Yuqlid/nmkgmmd_v10_brd/nmkgmmd_v10_brd.xlsx

Reference | Value | Footprint | Datasheet
SW2 | SW_DPDT_x2 | Buttons_Switches_SMD:SW_SPDT_PCM12 | https://www.digikey.jp/product-detail/ja/c-k/PCM12SMTR/401-2016-1-ND/1640125
U1 | STM32F303CCTx | Housings_QFP:LQFP-48_7x7mm_Pitch0.5mm | サンプル
SW1 | SKRPACE010 | SMD_Packages:ALPS_SKRPAxE010 | http://akizukidenshi.com/catalog/g/gP-06185/
R2 | 1k | Resistors_SMD:R_0603 | 手持ち
R1 | 1k | Resistors_SMD:R_0603 | 手持ち
Q3 | PSMN1R0-40YLD | SMD_Packages:LFPAK56_SO8_SOT1023 | http://akizukidenshi.com/catalog/g/gI-09031/
Q2 | PSMN1R0-40YLD | SMD_Packages:LFPAK56_SO8_SOT1023
Q9 | PSMN1R0-40YLD | SMD_Packages:LFPAK56_SO8_SOT1023
Q8 | PSMN1R0-40YLD | SMD_Packages:LFPAK56_SO8_SOT1023
Q7 | PSMN1R0-40YLD | SMD_Packages:LFPAK56_SO8_SOT1023
Q6 | PSMN1R0-40YLD | SMD_Packages:LFPAK56_SO8_SOT1023
Q4 | PSMN1R0-40YLD | SMD_Packages:LFPAK56_SO8_SOT1023
Q5 | PSMN1R0-40YLD | SMD_Packages:LFPAK56_SO8_SOT1023
Q11 | PSMN1R0-40YLD | SMD_Packages:LFPAK56_SO8_SOT1023
Q10 | PSMN1R0-40YLD | SMD_Packages:LFPAK56_SO8_SOT1023
Q17 | PSMN1R0-40YLD | SMD_Packages:LFPAK56_SO8_SOT1023
Q16 | PSMN1R0-40YLD | SMD_Packages:LFPAK56_SO8_SOT1023
Q15 | PSMN1R0-40YLD | SMD_Packages:LFPAK56_SO8_SOT1023
Q14 | PSMN1R0-40YLD | SMD_Packages:LFPAK56_SO8_SOT1023
Q12 | PSMN1R0-40YLD | SMD_Packages:LFPAK56_SO8_SOT1023
Q13 | PSMN1R0-40YLD | SMD_Packages:LFPAK56_SO8_SOT1023
U3 | MCP16301 | TO_SOT_Packages_SMD:SOT-23-6 | サンプル
U2 | MCP16301 | TO_SOT_Packages_SMD:SOT-23-6 | サンプル
D5 | LED | LEDs:LED_0603 | 秋月電子で適当に買ってくる
D4 | LED | LEDs:LED_0603
D3 | LED | LEDs:LED_0603
D2 | LED | LEDs:LED_0603
D1 | LED | LEDs:LED_0603
L2 | L | Inductors_NEOSID:Neosid_Inductor_SM0603CG | http://akizukidenshi.com/catalog/g/gP-10766/
L1 | L | Inductors_NEOSID:Neosid_Inductor_SM0603CG
D7 | D_Schottky | Diodes_SMD:D_SOD-123 | http://akizukidenshi.com/catalog/g/gI-02073/
D6 | D_Schottky | Diodes_SMD:D_SOD-123
D9 | D | Diodes_SMD:D_SOD-323_HandSoldering | https://www.digikey.jp/product-detail/ja/smc-diode-solutions/1N4148WSTR/1655-1359-1-ND/6022804
D8 | D | Diodes_SMD:D_SOD-323_HandSoldering
D11 | D | Diodes_SMD:D_SOD-123 | http://akizukidenshi.com/catalog/g/gI-02073/
D10 | D | Diodes_SMD:D_SOD-123
Y1 | Crystal | Crystals:NDK_Crystal_SMD_3225_2Pads | https://www.digikey.jp/product-detail/ja/ndk-america-inc/NX3225GD-8MHZ-STD-CRA-3/644-1178-1-ND/3125567
J9 | CONN_01X10 | Pin_Headers:Pin_Header_Straight_1x10_Pitch2.00mm_SMD_Pin1Right
J20 | CONN_01X10 | Pin_Headers:Pin_Header_Straight_1x10_Pitch2.00mm_SMD_Pin1Left
J14 | CONN_01X10 | Pin_Headers:Pin_Header_Straight_1x10_Pitch2.00mm_SMD_Pin1Left
J10 | CONN_01X10 | Pin_Headers:Pin_Header_Straight_1x10_Pitch2.00mm_SMD_Pin1Right
J1 | CONN_01X05 | Connectors_JST:JST_SH_BM05B-SRSS-TB_05x1.00mm_Straight
J6 | CONN_01X04 | Connectors_JST:JST_ZH_B04B-ZR_04x1.50mm_Straight | https://www.digikey.jp/product-detail/ja/jst-sales-america-inc/B4B-ZR(LF)(SN)/455-1659-ND/926566 |  | 千石で買える
J5 | CONN_01X04 | Connectors_JST:JST_ZH_S04B-ZR_04x1.50mm_Angled | https://www.digikey.jp/product-detail/ja/jst-sales-america-inc/S4B-ZR(LF)(SN)/455-1671-ND/926578
J4 | CONN_01X04 | Connectors_JST:JST_ZH_S04B-ZR_04x1.50mm_Angled | https://www.digikey.jp/product-detail/ja/jst-sales-america-inc/S4B-ZR(LF)(SN)/455-1671-ND/926578
J8 | CONN_01X03 | Connectors_JST:JST_ZH_S03B-ZR_03x1.50mm_Angled | https://www.digikey.jp/product-detail/ja/jst-sales-america-inc/S3B-ZR(LF)(SN)/455-1670-ND/926577
J7 | CONN_01X03 | Connectors_JST:JST_ZH_S03B-ZR_03x1.50mm_Angled | https://www.digikey.jp/product-detail/ja/jst-sales-america-inc/S3B-ZR(LF)(SN)/455-1670-ND/926577
J3 | CONN_01X03 | Connectors_JST:JST_ZH_S03B-ZR_03x1.50mm_Angled | https://www.digikey.jp/product-detail/ja/jst-sales-america-inc/S3B-ZR(LF)(SN)/455-1670-ND/926577
J2 | CONN_01X03 | Connectors_JST:JST_ZH_S03B-ZR_03x1.50mm_Angled | https://www.digikey.jp/product-detail/ja/jst-sales-america-inc/S3B-ZR(LF)(SN)/455-1670-ND/926577
J24 | CONN_01X01 | Mounting_Holes:MountingHole_2.7mm_Pad_Via
J23 | CONN_01X01 | Mounting_Holes:MountingHole_2.7mm_Pad_Via
J22 | CONN_01X01 | Mounting_Holes:MountingHole_2.7mm_Pad_Via
J21 | CONN_01X01 | Mounting_Holes:MountingHole_2.7mm_Pad_Via
J18 | CONN_01X01 | Mounting_Holes:MountingHole_2.7mm_Pad_Via
J17 | CONN_01X01 | Mounting_Holes:MountingHole_2.7mm_Pad_Via
J16 | CONN_01X01 | Mounting_Holes:MountingHole_2.7mm_Pad_Via
J15 | CONN_01X01 | Mounting_Holes:MountingHole_2.7mm_Pad_Via
C38 | C | Capacitors_SMD:C_0603 |  | https://www.digikey.jp/product-detail/ja/kemet/C0603C104K5RACTU/399-5089-1-ND/1465623 | 0.1uでよくね
C37 | C | Capacitors_SMD:C_0603
C36 | C | Capacitors_SMD:C_0603
C35 | C | Capacitors_SMD:C_0603
C34 | C | Capacitors_SMD:C_0603
C33 | C | Capacitors_SMD:C_0603
C32 | C | Capacitors_SMD:C_0603
C31 | C | Capacitors_SMD:C_0603
Q18 | BSS138 | TO_SOT_Packages_SMD:SOT-23 | http://akizukidenshi.com/catalog/g/gI-11627/
Q1 | BSS138 | TO_SOT_Packages_SMD:SOT-23 | http://akizukidenshi.com/catalog/g/gI-11627/
U7 | ACS711 | Housings_DFN_QFN:QFN-12_3x3mm_Pitch0.5mm_With_Fused_Sensed_Current_Loop | https://www.digikey.jp/product-detail/ja/allegro-microsystems-llc/ACS711KEXLT-31AB-T/620-1482-1-ND/3868202
U5 | ACS711 | Housings_DFN_QFN:QFN-12_3x3mm_Pitch0.5mm_With_Fused_Sensed_Current_Loop | https://www.digikey.jp/product-detail/ja/allegro-microsystems-llc/ACS711KEXLT-31AB-T/620-1482-1-ND/3868202
U6 | A4957 | SMD_Packages:Allegro_A4957_QFN-24-1EP_4x4mm_Pitch0.5mm | https://www.digikey.jp/product-detail/ja/allegro-microsystems-llc/A4957SESTR-T/620-1491-1-ND/3906431
U4 | A4957 | SMD_Packages:Allegro_A4957_QFN-24-1EP_4x4mm_Pitch0.5mm | https://www.digikey.jp/product-detail/ja/allegro-microsystems-llc/A4957SESTR-T/620-1491-1-ND/3906431
R15 | 52.3k | Resistors_SMD:R_0603 | https://www.digikey.jp/product-detail/ja/yageo/RC0603FR-0752K3L/311-52.3KHRCT-ND/730237
C27 | 4.4u | Capacitors_SMD:C_0805 | https://www.digikey.jp/product-detail/ja/samsung-electro-mechanics-america-inc/CL21A475KOFNNNG/1276-6463-1-ND/5958091 |  | 0.22u×20=4.4u<4.7u で
C20 | 4.4u | Capacitors_SMD:C_0805
C26 | 470n | Capacitors_SMD:C_0603 | https://www.digikey.jp/product-detail/ja/taiyo-yuden/UMK107B7474KA-TR/587-3170-1-ND/3194939
C19 | 470n | Capacitors_SMD:C_0603
R10 | 40k | Resistors_SMD:R_0603 | https://www.digikey.jp/product-detail/ja/yageo/RC0603FR-0739K2L/311-39.2KHRCT-ND/730144 |  | 39.2k
R17 | 31.6k | Resistors_SMD:R_0603 | https://www.digikey.jp/product-detail/ja/yageo/RC0603FR-0731K6L/311-31.6KHRCT-ND/730098
L3 | 22u | Choke_SMD:Choke_SMD_BOURNS-SRR4028-xxxY | https://www.digikey.jp/product-detail/ja/bourns-inc/SRN4026-220M/SRN4026-220MCT-ND/4867777
C15 | 20u | Capacitors_SMD:C_0805 | http://akizukidenshi.com/catalog/g/gP-06057/
C9 | 1u | Capacitors_SMD:C_0603 | http://akizukidenshi.com/catalog/g/gP-09633/
C4 | 1u | Capacitors_SMD:C_0603
R9 | 1k | Resistors_SMD:R_0603 | https://www.digikey.jp/product-detail/ja/yageo/RC0603FR-071KL/311-1.00KHRCT-ND/729790
R8 | 1k | Resistors_SMD:R_0603
R7 | 1k | Resistors_SMD:R_0603
L4 | 15u | Choke_SMD:Choke_SMD_BOURNS-SRR4028-xxxY | https://www.digikey.jp/product-detail/ja/bourns-inc/SRN4012TA-150M/SRN4012TA-150MCT-ND/6155227
C3 | 14p | Capacitors_SMD:C_0603 | https://www.digikey.jp/product-detail/ja/samsung-electro-mechanics-america-inc/CL10C140JB8NNNC/1276-2187-1-ND/3890273
C2 | 14p | Capacitors_SMD:C_0603
C16 | 10u | Capacitors_SMD:C_0805 | http://akizukidenshi.com/catalog/g/gP-06057/ |  | 5Vよ同じように22uF付ける
C12 | 10u | Capacitors_SMD:C_0805 | http://akizukidenshi.com/catalog/g/gP-06462/ |  | ミスったのでこっちも3216サイズに変更
C11 | 10u | Capacitors_SMD:C_0805
R6 | 10k | Resistors_SMD:R_0603 | https://www.digikey.jp/product-detail/ja/susumu/RR0816P-103-D/RR08P10.0KDCT-ND/432748 |  | 部室にある
R52 | 10k | Resistors_SMD:R_0603
R51 | 10k | Resistors_SMD:R_0603
R5 | 10k | Resistors_SMD:R_0603
R48 | 10k | Resistors_SMD:R_0603
R47 | 10k | Resistors_SMD:R_0603
R46 | 10k | Resistors_SMD:R_0603
R45 | 10k | Resistors_SMD:R_0603
R42 | 10k | Resistors_SMD:R_0603
R41 | 10k | Resistors_SMD:R_0603
R4 | 10k | Resistors_SMD:R_0603
R37 | 10k | Resistors_SMD:R_0603
R34 | 10k | Resistors_SMD:R_0603
R33 | 10k | Resistors_SMD:R_0603
R30 | 10k | Resistors_SMD:R_0603
R3 | 10k | Resistors_SMD:R_0603
R29 | 10k | Resistors_SMD:R_0603
R28 | 10k | Resistors_SMD:R_0603
R27 | 10k | Resistors_SMD:R_0603
R24 | 10k | Resistors_SMD:R_0603
R23 | 10k | Resistors_SMD:R_0603
R19 | 10k | Resistors_SMD:R_0603
R18 | 10k | Resistors_SMD:R_0603
R16 | 10k | Resistors_SMD:R_0603
R14 | 10k | Resistors_SMD:R_0603
R13 | 10k | Resistors_SMD:R_0603
R12 | 10k | Resistors_SMD:R_0603
R11 | 10k | Resistors_SMD:R_0603
C29 | 0.22u | Capacitors_SMD:C_0603 | https://www.digikey.jp/product-detail/ja/tdk-corporation/C1608X7R1C224K080AC/445-1318-1-ND/567690 |  | 0.22uFあればいいと思う
C28 | 0.22u | Capacitors_SMD:C_0603
C22 | 0.22u | Capacitors_SMD:C_0603
C21 | 0.22u | Capacitors_SMD:C_0603
C8 | 0.1u | Capacitors_SMD:C_0603 | https://www.digikey.jp/product-detail/ja/kemet/C0603C104K5RACTU/399-5089-1-ND/1465623 |  | 部室にある
C7 | 0.1u | Capacitors_SMD:C_0603
C6 | 0.1u | Capacitors_SMD:C_0603
C5 | 0.1u | Capacitors_SMD:C_0603
C30 | 0.1u | Capacitors_SMD:C_0603
C25 | 0.1u | Capacitors_SMD:C_0603
C24 | 0.1u | Capacitors_SMD:C_0603
C23 | 0.1u | Capacitors_SMD:C_0603
C18 | 0.1u | Capacitors_SMD:C_0603
C17 | 0.1u | Capacitors_SMD:C_0603
C14 | 0.1u | Capacitors_SMD:C_0603
C13 | 0.1u | Capacitors_SMD:C_0603
C10 | 0.1u | Capacitors_SMD:C_0603
C1 | 0.1u | Capacitors_SMD:C_0603
R54 | 10 | Resistors_SMD:R_0603 | https://www.sengoku.co.jp/mod/sgk_cart/detail.php?code=7APR-EFEC
R53 | 10 | Resistors_SMD:R_0603
R50 | 10 | Resistors_SMD:R_0603
R49 | 10 | Resistors_SMD:R_0603
R44 | 10 | Resistors_SMD:R_0603
R43 | 10 | Resistors_SMD:R_0603
R40 | 10 | Resistors_SMD:R_0603
R39 | 10 | Resistors_SMD:R_0603
R36 | 10 | Resistors_SMD:R_0603
R35 | 10 | Resistors_SMD:R_0603
R32 | 10 | Resistors_SMD:R_0603
R31 | 10 | Resistors_SMD:R_0603
R26 | 10 | Resistors_SMD:R_0603
R25 | 10 | Resistors_SMD:R_0603
R22 | 10 | Resistors_SMD:R_0603
R21 | 10 | Resistors_SMD:R_0603
R38 | 0 | Resistors_SMD:R_0603 | http://akizukidenshi.com/catalog/g/gR-11619/
R20 | 0 | Resistors_SMD:R_0603
