Yuqlid/nmkgmmd_v10_brd/nmkgmmd_v10_brd.kicad_pcb

## KiCad design nmkgmmd_v10_brd.kicad_pcb (2017-05-09)

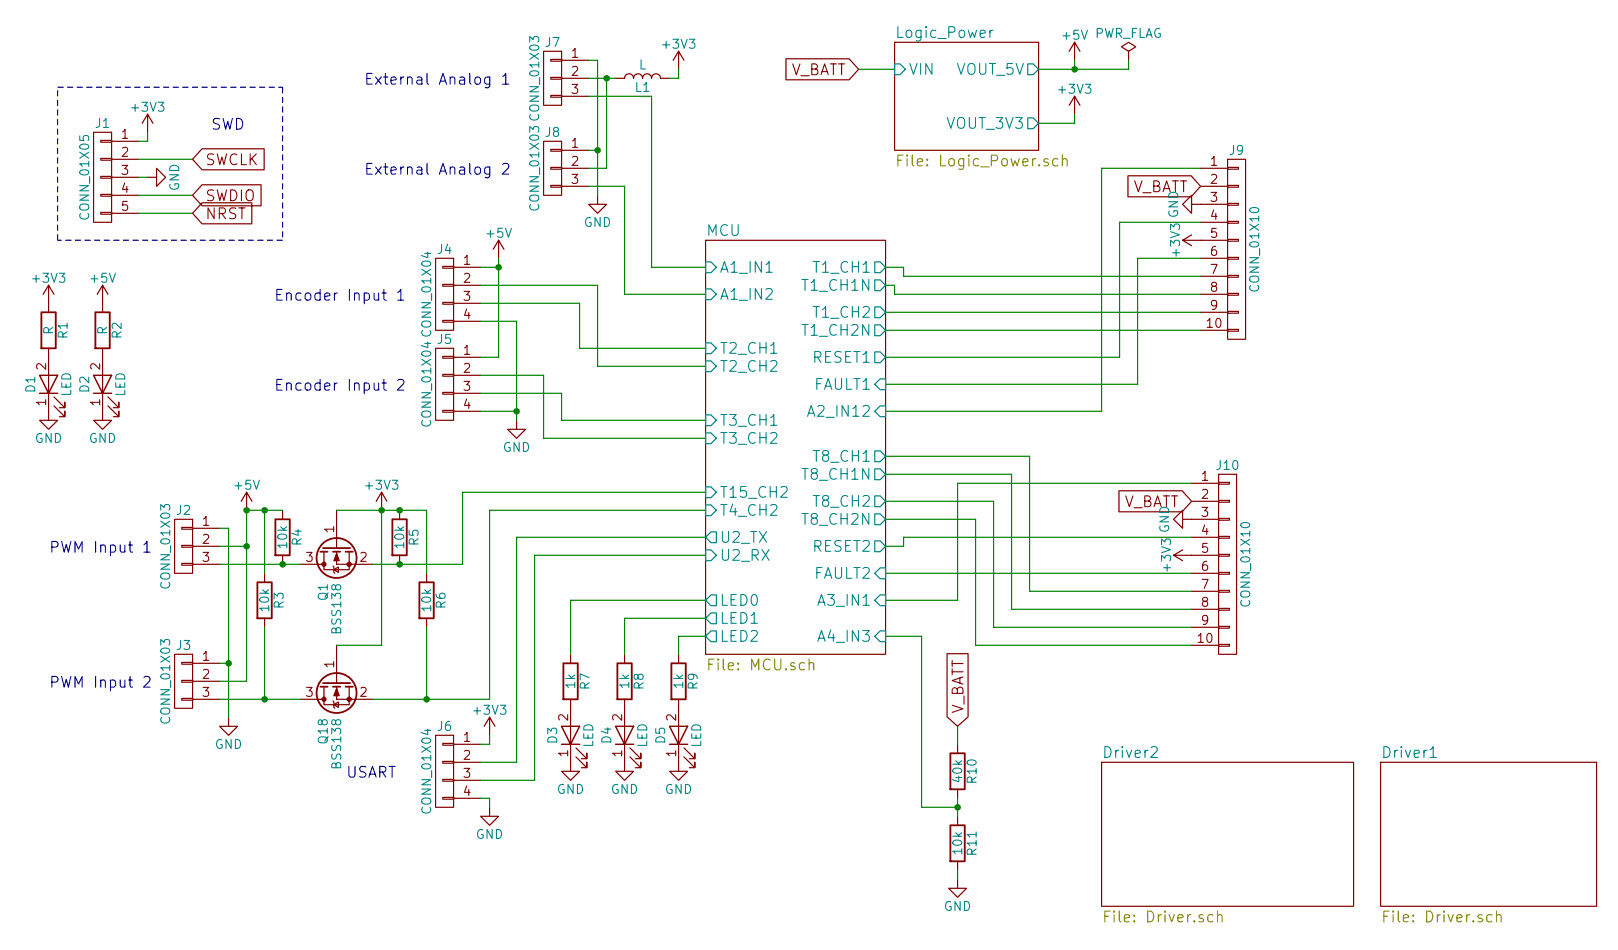
[picture p1: schematic nmkgmmd_v10_brd.sch]

Parts:
D1, D2, D3, D4, D5: LED; LED_0603
J1: CONN_01X05; JST_SH_BM05B-SRSS-TB_05x1.00mm_Straight
J2, J3, J7, J8: CONN_01X03; JST_ZH_S03B-ZR_03x1.50mm_Angled
J4, J5: CONN_01X04; JST_ZH_S04B-ZR_04x1.50mm_Angled
J6: CONN_01X04; JST_ZH_B04B-ZR_04x1.50mm_Straight
J9, J10: CONN_01X10; Pin_Header_Straight_1x10_Pitch2.00mm_SMD_Pin1Right
L1: L; Neosid_Inductor_SM0603CG
Q1, Q18: BSS138; SOT-23
R1, R2: R; R_0603
R3, R4, R5, R6, R11: 10k; R_0603
R7, R8, R9: 1k; R_0603
R10: 40k; R_0603

Connections:
+3V3: J1.1, J6.1, J9.5, J10.5, L1.2, Q1.1 (G), Q18.1 (G), R1.1, R5.1, R6.1; also elsewhere on the board
+5V: J2.2, J3.2, J4.1, J5.1, R2.1, R3.1, R4.1; also elsewhere on the board
/MCU/A1_IN1: J7.3; also elsewhere on the board
/MCU/A1_IN2: J8.3; also elsewhere on the board
/MCU/A2_IN12: J9.1; also elsewhere on the board
/MCU/A3_IN1: J10.1; also elsewhere on the board
/MCU/A4_IN3: R10.2, R11.1; also elsewhere on the board
/MCU/FAULT1: J9.6; also elsewhere on the board
/MCU/FAULT2: J10.6; also elsewhere on the board
/MCU/LED0: R7.1; also elsewhere on the board
/MCU/LED1: R8.1; also elsewhere on the board
/MCU/LED2: R9.1; also elsewhere on the board
/MCU/RESET1: J9.4; also elsewhere on the board
/MCU/RESET2: J10.4; also elsewhere on the board
/MCU/T1_CH1: J9.7; also elsewhere on the board
/MCU/T1_CH1N: J9.8; also elsewhere on the board
/MCU/T1_CH2: J9.9; also elsewhere on the board
/MCU/T1_CH2N: J9.10; also elsewhere on the board
/MCU/T2_CH1: J4.3; also elsewhere on the board
/MCU/T2_CH2: J4.2; also elsewhere on the board
/MCU/T3_CH1: J5.3; also elsewhere on the board
/MCU/T3_CH2: J5.2; also elsewhere on the board
/MCU/T4_CH2: Q18.2 (S), R6.2; also elsewhere on the board
/MCU/T8_CH1: J10.7; also elsewhere on the board
/MCU/T8_CH1N: J10.8; also elsewhere on the board
/MCU/T8_CH2: J10.9; also elsewhere on the board
/MCU/T8_CH2N: J10.10; also elsewhere on the board
/MCU/T15_CH2: Q1.2 (S), R5.2; also elsewhere on the board
/MCU/U2_RX: J6.3; also elsewhere on the board
/MCU/U2_TX: J6.2; also elsewhere on the board
GND: D1.1 (K), D2.1 (K), D3.1 (K), D4.1 (K), D5.1 (K), J1.3, J2.1, J3.1, J4.4, J5.4, J6.4, J7.1, J8.1, J9.3, J10.3, R11.2; also elsewhere on the board
NRST: J1.5; also elsewhere on the board
unnamed: D1.2 (A), R1.2
unnamed: D2.2 (A), R2.2
unnamed: D3.2 (A), R7.2
unnamed: D4.2 (A), R8.2
unnamed: D5.2 (A), R9.2
unnamed: J2.3, Q1.3 (D), R4.2
unnamed: J3.3, Q18.3 (D), R3.2
unnamed: J7.2, J8.2, L1.1
SWCLK: J1.2; also elsewhere on the board
SWDIO: J1.4; also elsewhere on the board
V_BATT: J9.2, J10.2, R10.1; also elsewhere on the board

Notes on the sheet:
SWD
Encoder Input 1
Encoder Input 2
External Analog 1
External Analog 2
PWM Input 1
PWM Input 2
USART

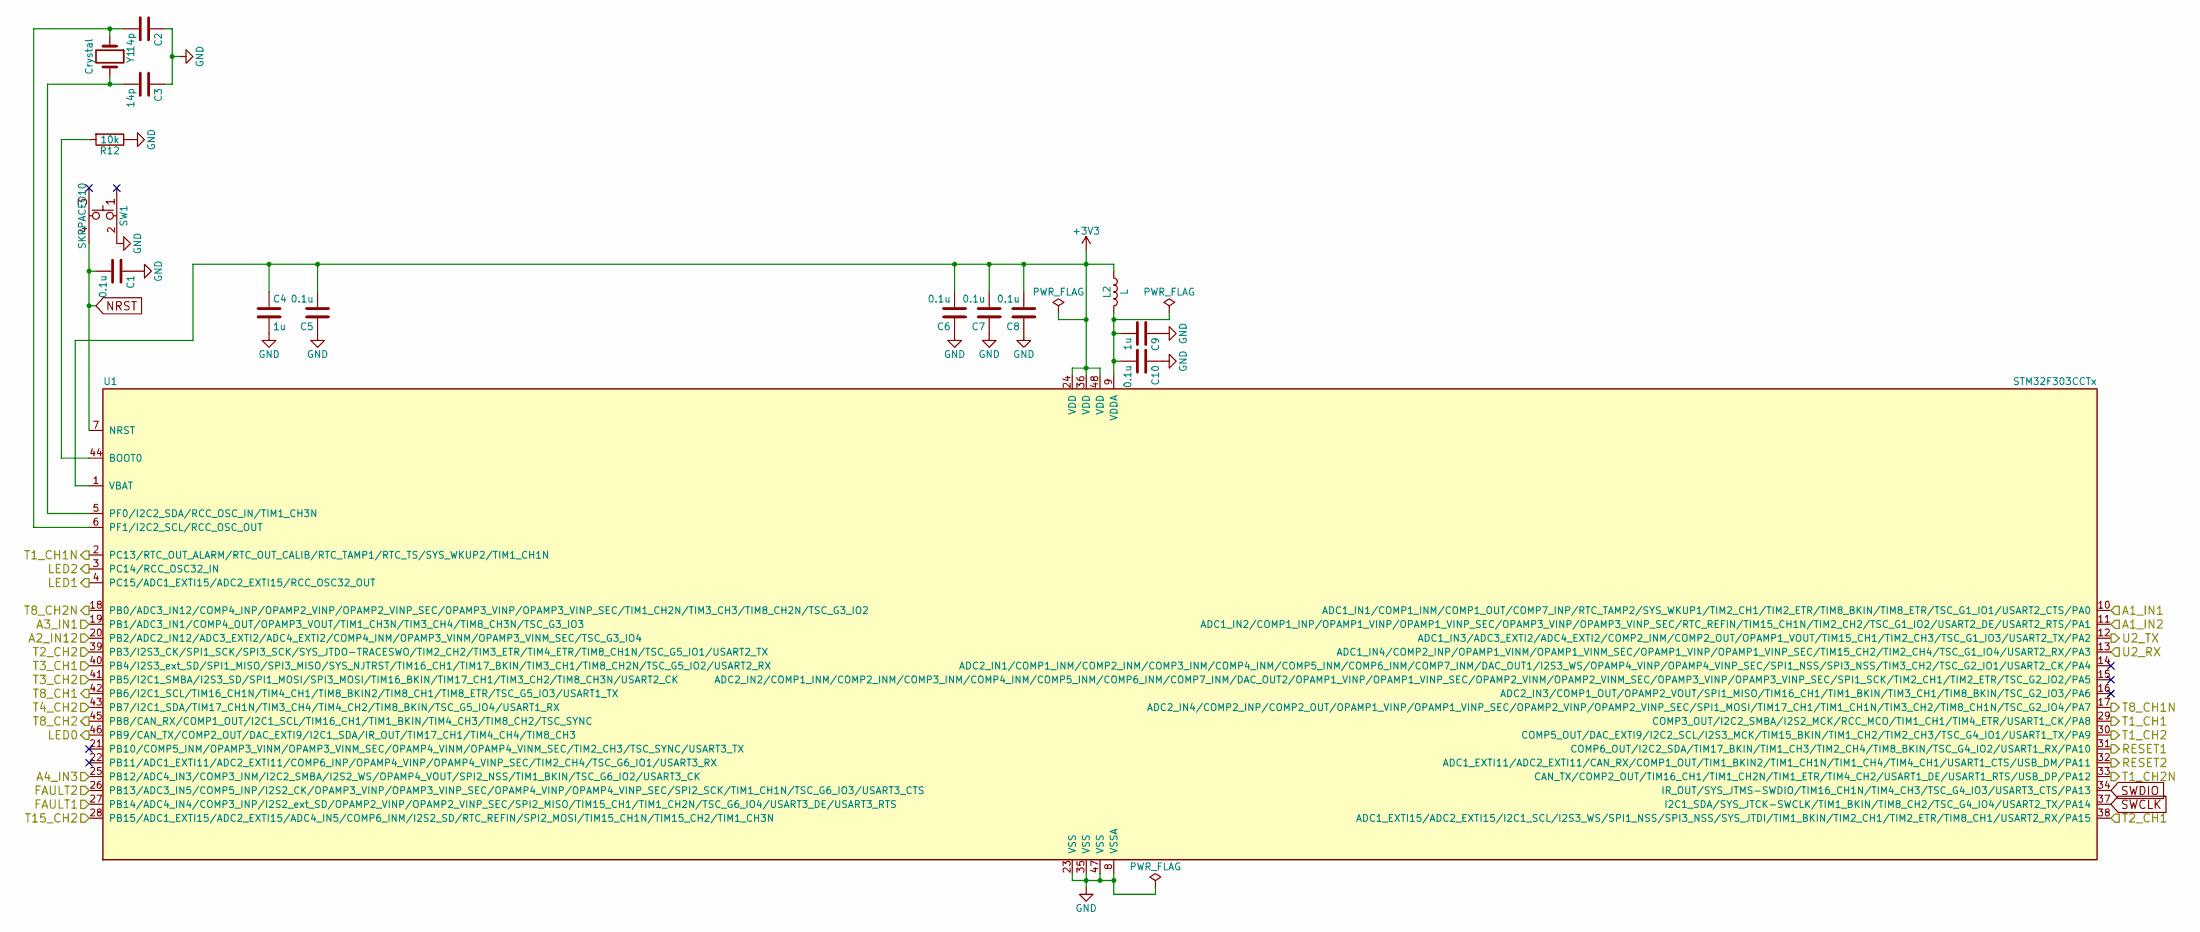
[picture p2: schematic MCU.sch]

Parts:
C1, C5, C6, C7, C8, C10: 0.1u; C_0603
C2, C3: 14p; C_0603
C4, C9: 1u; C_0603
L2: L; Neosid_Inductor_SM0603CG
R12: 10k; R_0603
SW1: SKRPACE010; ALPS_SKRPAxE010
U1: STM32F303CCTx; LQFP-48_7x7mm_Pitch0.5mm
Y1: Crystal; NDK_Crystal_SMD_3225_2Pads

Connections:
+3V3: C4.1, C5.2, C6.2, C7.2, C8.2, L2.1, U1.1 (VBAT), U1.24 (VDD), U1.36 (VDD), U1.48 (VDD); also elsewhere on the board
/MCU/A1_IN1: U1.10 (ADC1_IN1/COMP1_INM/COMP1_OUT/COMP7_INP/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); also elsewhere on the board
/MCU/A1_IN2: U1.11 (ADC1_IN2/COMP1_INP/OPAMP1_VINP/OPAMP1_V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); also elsewhere on the board
/MCU/A2_IN12: U1.20 (PB2/ADC2_IN12/ADC3_EXTI2/ADC4_EXTI2/COM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); also elsewhere on the board
/MCU/A3_IN1: U1.19 (PB1/ADC3_IN1/COMP4_OUT/OPAMP3_VOUT/TIM1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); also elsewhere on the board
/MCU/A4_IN3: U1.25 (PB12/ADC4_IN3/COMP3_INM/I2C2_SMBA/I2S2_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); also elsewhere on the board
/MCU/FAULT1: U1.27 (PB14/ADC4_IN4/COMP3_INP/I2S2_ext_SD/OPA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); also elsewhere on the board
/MCU/FAULT2: U1.26 (PB13/ADC3_IN5/COMP5_INP/I2S2_CK/OPAMP3_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); also elsewhere on the board
/MCU/LED0: U1.46 (PB9/CAN_TX/COMP2_OUT/DAC_EXTI9/I2C1_SDA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); also elsewhere on the board
/MCU/LED1: U1.4 (PC15/ADC1_EXTI15/ADC2_EXTI15/RCC_OSC32_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); also elsewhere on the board
/MCU/LED2: U1.3 (PC14/RCC_OSC32_IN); also elsewhere on the board
/MCU/RESET1: U1.31 (COMP6_OUT/I2C2_SDA/TIM17_BKIN/TIM1_CH3/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); also elsewhere on the board
/MCU/RESET2: U1.32 (ADC1_EXTI11/ADC2_EXTI11/CAN_RX/COMP1_OU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); also elsewhere on the board
/MCU/T1_CH1: U1.29 (COMP3_OUT/I2C2_SMBA/I2S2_MCK/RCC_MCO/TI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); also elsewhere on the board
/MCU/T1_CH1N: U1.2 (PC13/RTC_OUT_ALARM/RTC_OUT_CALIB/RTC_TA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); also elsewhere on the board
/MCU/T1_CH2: U1.30 (COMP5_OUT/DAC_EXTI9/I2C2_SCL/I2S3_MCK/T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); also elsewhere on the board
/MCU/T1_CH2N: U1.33 (CAN_TX/COMP2_OUT/TIM16_CH1/TIM1_CH2N/TI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); also elsewhere on the board
/MCU/T2_CH1: U1.38 (ADC1_EXTI15/ADC2_EXTI15/I2C1_SCL/I2S3_W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); also elsewhere on the board
/MCU/T2_CH2: U1.39 (PB3/I2S3_CK/SPI1_SCK/SPI3_SCK/SYS_JTDO-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); also elsewhere on the board
/MCU/T3_CH1: U1.40 (PB4/I2S3_ext_SD/SPI1_MISO/SPI3_MISO/SYS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); also elsewhere on the board
/MCU/T3_CH2: U1.41 (PB5/I2C1_SMBA/I2S3_SD/SPI1_MOSI/SPI3_MO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); also elsewhere on the board
/MCU/T4_CH2: U1.43 (PB7/I2C1_SDA/TIM17_CH1N/TIM3_CH4/TIM4_C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); also elsewhere on the board
/MCU/T8_CH1: U1.42 (PB6/I2C1_SCL/TIM16_CH1N/TIM4_CH1/TIM8_B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); also elsewhere on the board
/MCU/T8_CH1N: U1.17 (ADC2_IN4/COMP2_INP/COMP2_OUT/OPAMP1_VIN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); also elsewhere on the board
/MCU/T8_CH2: U1.45 (PB8/CAN_RX/COMP1_OUT/I2C1_SCL/TIM16_CH1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); also elsewhere on the board
/MCU/T8_CH2N: U1.18 (PB0/ADC3_IN12/COMP4_INP/OPAMP2_VINP/OPA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); also elsewhere on the board
/MCU/T15_CH2: U1.28 (PB15/ADC1_EXTI15/ADC2_EXTI15/ADC4_IN5/C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); also elsewhere on the board
/MCU/U2_RX: U1.13 (ADC1_IN4/COMP2_INP/OPAMP1_VINM/OPAMP1_V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); also elsewhere on the board
/MCU/U2_TX: U1.12 (ADC1_IN3/ADC3_EXTI2/ADC4_EXTI2/COMP2_IN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); also elsewhere on the board
GND: C1.1, C2.1, C3.1, C4.2, C5.1, C6.1, C7.1, C8.1, C9.1, C10.1, R12.1, SW1.2, U1.8 (VSSA), U1.23 (VSS), U1.35 (VSS), U1.47 (VSS); also elsewhere on the board
NRST: C1.2, SW1.4, U1.7 (NRST); also elsewhere on the board
unnamed: C2.2, U1.6 (PF1/I2C2_SCL/RCC_OSC_OUT), Y1.1
unnamed: C3.2, U1.5 (PF0/I2C2_SDA/RCC_OSC_IN/TIM1_CH3N), Y1.2
unnamed: C9.2, C10.2, L2.2, U1.9 (VDDA)
unnamed: R12.2, U1.44 (BOOT0)
SWCLK: U1.37 (I2C1_SDA/SYS_JTCK-SWCLK/TIM1_BKIN/TIM8_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); also elsewhere on the board
SWDIO: U1.34 (IR_OUT/SYS_JTMS-SWDIO/TIM16_CH1N/TIM4_C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); also elsewhere on the board

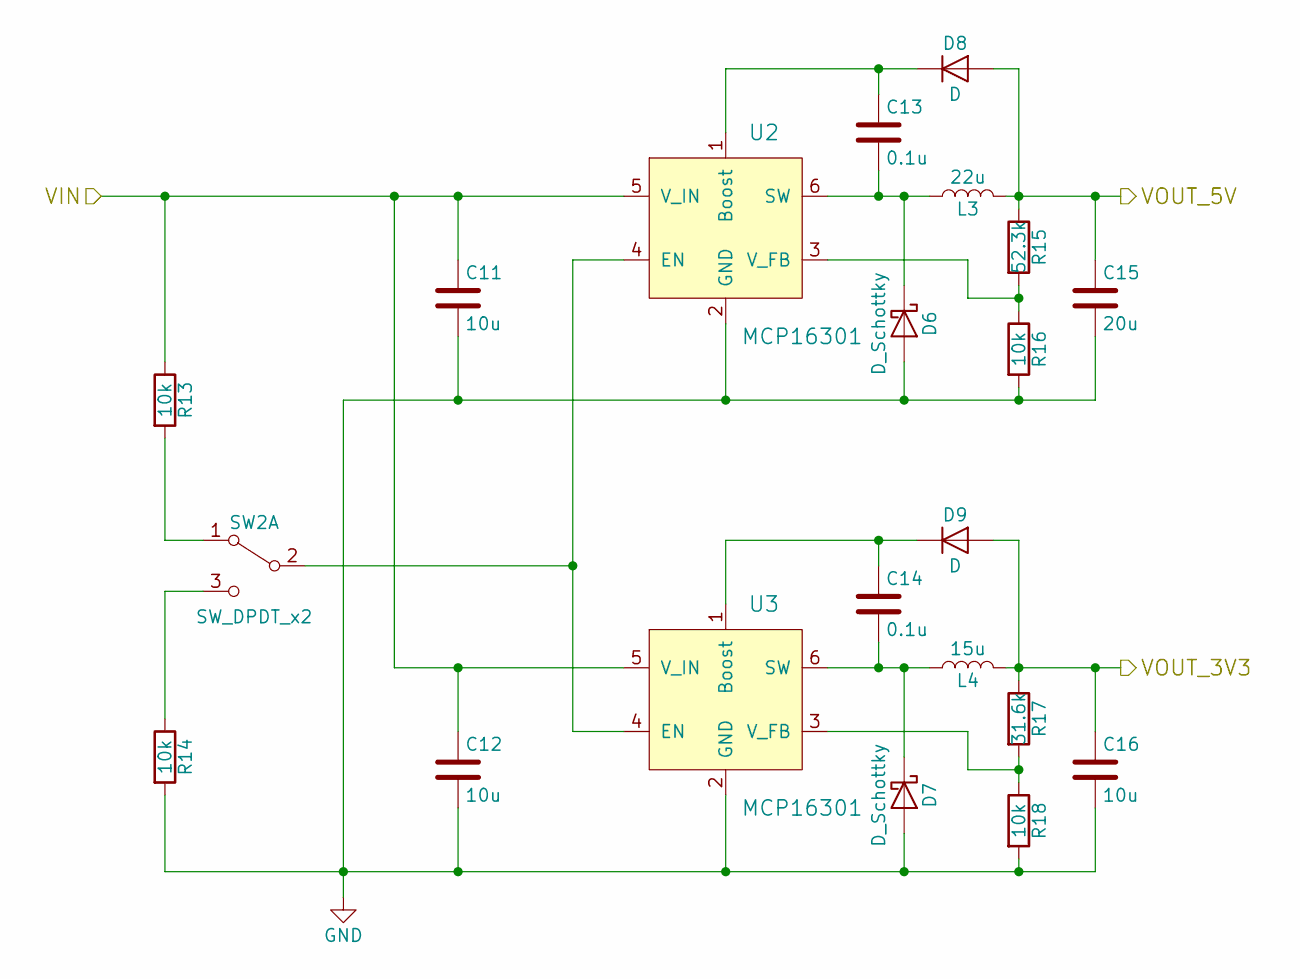
[picture p3: schematic Logic_Power.sch]

Parts:
C11, C12, C16: 10u; C_0805
C13, C14: 0.1u; C_0603
C15: 20u; C_0805
D6, D7: D_Schottky; D_SOD-123
D8, D9: D; D_SOD-323_HandSoldering
L3: 22u; Choke_SMD_BOURNS-SRR4028-xxxY
L4: 15u; Choke_SMD_BOURNS-SRR4028-xxxY
R13, R14, R16, R18: 10k; R_0603
R15: 52.3k; R_0603
R17: 31.6k; R_0603
SW2: SW_DPDT_x2; SW_SPDT_PCM12
U2, U3: MCP16301; SOT-23-6

Connections:
+3V3: C16.1, D9.2 (A), L4.2, R17.1; also elsewhere on the board
+5V: C15.1, D8.2 (A), L3.2, R15.1; also elsewhere on the board
GND: C11.2, C12.2, C15.2, C16.2, D6.2 (A), D7.2 (A), R14.2, R16.2, R18.2, U2.2 (GND), U3.2 (GND); also elsewhere on the board
unnamed: C13.1, D8.1 (K), U2.1 (Boost)
unnamed: C13.2, D6.1 (K), L3.1, U2.6 (SW)
unnamed: C14.1, D9.1 (K), U3.1 (Boost)
unnamed: C14.2, D7.1 (K), L4.1, U3.6 (SW)
unnamed: R13.2, SW2.1 (A)
unnamed: R14.1, SW2.3 (C)
unnamed: R15.2, R16.1, U2.3 (V_FB)
unnamed: R17.2, R18.1, U3.3 (V_FB)
unnamed: SW2.2 (B), U2.4 (EN), U3.4 (EN)
V_BATT: C11.1, C12.1, R13.1, U2.5 (V_IN), U3.5 (V_IN); also elsewhere on the board

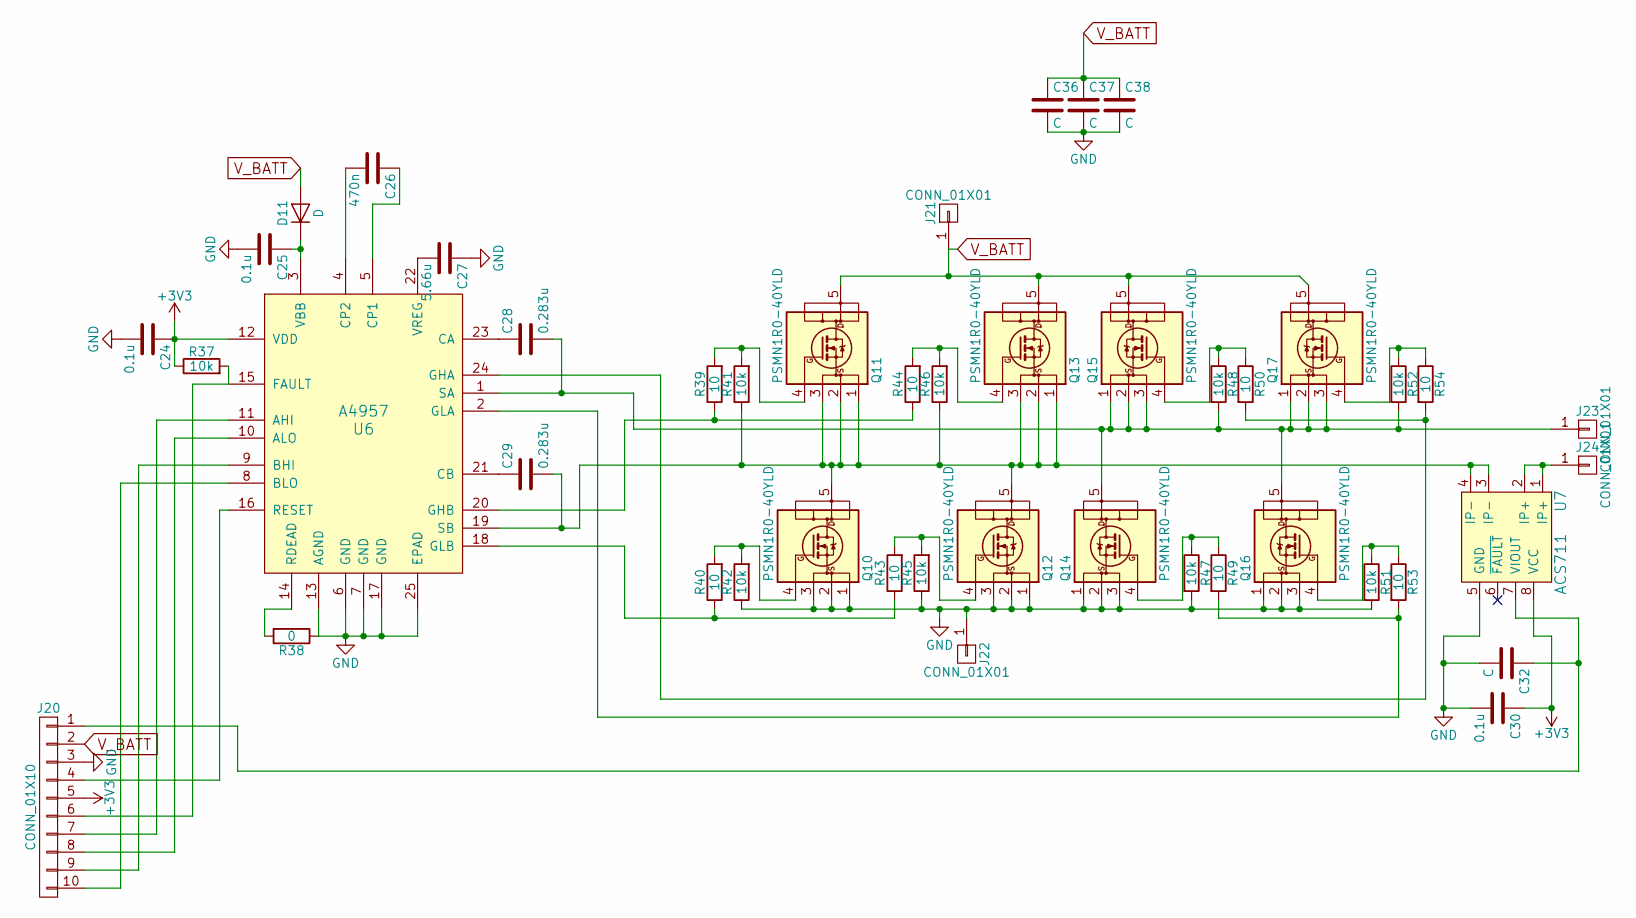
[picture p4: schematic Driver.sch]

Parts:
C17, C18, C23: 0.1u; C_0603
C19: 470n; C_0603
C20: 5.66u; C_0805
C21, C22: 0.283u; C_0603
C32, C33, C34, C35: C; C_0603
D10: D; D_SOD-123
J14: CONN_01X10; Pin_Header_Straight_1x10_Pitch2.00mm_SMD_Pin1Left
J15, J16, J17, J18: CONN_01X01; MountingHole_2.7mm_Pad_Via
Q2, Q3, Q4, Q5, Q6, Q7, Q8, Q9: PSMN1R0-40YLD; LFPAK56_SO8_SOT1023
R19, R23, R24, R27, R28, R29, R30, R33, R34: 10k; R_0603
R20: 0; R_0603
R21, R22, R25, R26, R31, R32, R35, R36: 10; R_0603
U4: A4957; Allegro_A4957_QFN-24-1EP_4x4mm_Pitch0.5mm
U7: ACS711; QFN-12_3x3mm_Pitch0.5mm_With_Fused_Sensed_Current_Loop

Connections:
+3V3: C17.1, C23.1, J14.5, R19.1, U4.12 (VDD), U7.8 (VCC); also elsewhere on the board
GND: C17.2, C18.2, C20.1, C23.2, C32.2, C33.2, C34.2, C35.2, J14.3, J16.1, Q2.1 (S), Q2.2 (S), Q2.3 (S), Q4.1 (S), Q4.2 (S), Q4.3 (S), Q6.1 (S), Q6.2 (S), Q6.3 (S), Q8.1 (S), Q8.2 (S), Q8.3 (S), R20.1, R24.1, R27.1, R29.2, R33.2, U4.6 (GND), U4.7 (GND), U4.13 (AGND), U4.17 (GND), U4.25 (EPAD), U7.5 (GND); also elsewhere on the board
unnamed: C18.1, D10.1 (K), U4.3 (VBB)
unnamed: C19.1, U4.5 (CP1)
unnamed: C19.2, U4.4 (CP2)
unnamed: C20.2, U4.22 (VREG)
unnamed: C21.1, U4.23 (CA)
unnamed: C21.2, J17.1, Q6.5 (D), Q7.1 (S), Q7.2 (S), Q7.3 (S), Q8.5 (D), Q9.1 (S), Q9.2 (S), Q9.3 (S), R30.2, R34.2, U4.1 (SA)
unnamed: C22.1, U4.21 (CB)
unnamed: J14.4, U4.16 (RESET)
unnamed: J14.6, R19.2, U4.15 (FAULT)
unnamed: J14.7, U4.11 (AHI)
unnamed: J14.8, U4.10 (ALO)
unnamed: J14.9, U4.9 (BHI)
unnamed: J14.10, U4.8 (BLO)
unnamed: Q2.4 (G), R22.2, R24.2
unnamed: Q3.4 (G), R21.2, R23.2
unnamed: Q4.4 (G), R25.2, R27.2
unnamed: Q5.4 (G), R26.2, R28.2
unnamed: Q6.4 (G), R29.1, R31.1
unnamed: Q7.4 (G), R30.1, R32.1
unnamed: Q8.4 (G), R33.1, R35.1
unnamed: Q9.4 (G), R34.1, R36.1
unnamed: R20.2, U4.14 (RDEAD)
unnamed: R21.1, R26.1, U4.20 (GHB)
unnamed: R22.1, R25.1, U4.18 (GLB)
unnamed: R31.2, R35.2, U4.2 (GLA)
unnamed: R32.2, R36.2, U4.24 (GHA)
V_BATT: C33.1, C34.1, C35.1, D10.2 (A), J14.2, J15.1, Q3.5 (D), Q5.5 (D), Q7.5 (D), Q9.5 (D); also elsewhere on the board

Parts of its further copies:
C24, C25, C30: 0.1u; C_0603
C27: 5.66u; C_0805
C28, C29: 0.283u; C_0603
C31, C36, C37, C38: C; C_0603
D11: D; D_SOD-123
J20: CONN_01X10; Pin_Header_Straight_1x10_Pitch2.00mm_SMD_Pin1Left
J21, J22, J23, J24: CONN_01X01; MountingHole_2.7mm_Pad_Via
Q10, Q11, Q12, Q13, Q14, Q15, Q16, Q17: PSMN1R0-40YLD; LFPAK56_SO8_SOT1023
R37, R41, R42, R45, R46, R47, R48, R51, R52: 10k; R_0603
R38: 0; R_0603
R39, R40, R43, R44, R49, R50, R53, R54: 10; R_0603
U5: ACS711; QFN-12_3x3mm_Pitch0.5mm_With_Fused_Sensed_Current_Loop
U6: A4957; Allegro_A4957_QFN-24-1EP_4x4mm_Pitch0.5mm

Connections of its further copies:
+3V3: C24.1, C30.1, J20.5, R37.1, U5.8 (VCC), U6.12 (VDD); also elsewhere on the board
GND: C24.2, C25.2, C27.1, C30.2, C31.2, C36.2, C37.2, C38.2, J20.3, J22.1, Q10.1 (S), Q10.2 (S), Q10.3 (S), Q12.1 (S), Q12.2 (S), Q12.3 (S), Q14.1 (S), Q14.2 (S), Q14.3 (S), Q16.1 (S), Q16.2 (S), Q16.3 (S), R38.1, R42.1, R45.1, R47.2, R51.2, U5.5 (GND), U6.6 (GND), U6.7 (GND), U6.13 (AGND), U6.17 (GND), U6.25 (EPAD); also elsewhere on the board
unnamed: C25.1, D11.1 (K), U6.3 (VBB)
unnamed 47: U6.5 (CP1); also elsewhere on the board
unnamed 48: U6.4 (CP2); also elsewhere on the board
unnamed: C27.2, U6.22 (VREG)
unnamed: C28.1, U6.23 (CA)
unnamed: C28.2, J23.1, Q14.5 (D), Q15.1 (S), Q15.2 (S), Q15.3 (S), Q16.5 (D), Q17.1 (S), Q17.2 (S), Q17.3 (S), R48.2, R52.2, U6.1 (SA)
unnamed: C29.1, U6.21 (CB)
unnamed: J20.4, U6.16 (RESET)
unnamed: J20.6, R37.2, U6.15 (FAULT)
unnamed: J20.7, U6.11 (AHI)
unnamed: J20.8, U6.10 (ALO)
unnamed: J20.9, U6.9 (BHI)
unnamed: J20.10, U6.8 (BLO)
unnamed: Q10.4 (G), R40.2, R42.2
unnamed: Q11.4 (G), R39.2, R41.2
unnamed: Q12.4 (G), R43.2, R45.2
unnamed: Q13.4 (G), R44.2, R46.2
unnamed: Q14.4 (G), R47.1, R49.1
unnamed: Q15.4 (G), R48.1, R50.1
unnamed: Q16.4 (G), R51.1, R53.1
unnamed: Q17.4 (G), R52.1, R54.1
unnamed: R38.2, U6.14 (RDEAD)
unnamed: R39.1, R44.1, U6.20 (GHB)
unnamed: R40.1, R43.1, U6.18 (GLB)
unnamed: R49.2, R53.2, U6.2 (GLA)
unnamed: R50.2, R54.2, U6.24 (GHA)
V_BATT: C36.1, C37.1, C38.1, D11.2 (A), J20.2, J21.1, Q11.5 (D), Q13.5 (D), Q15.5 (D), Q17.5 (D); also elsewhere on the board

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
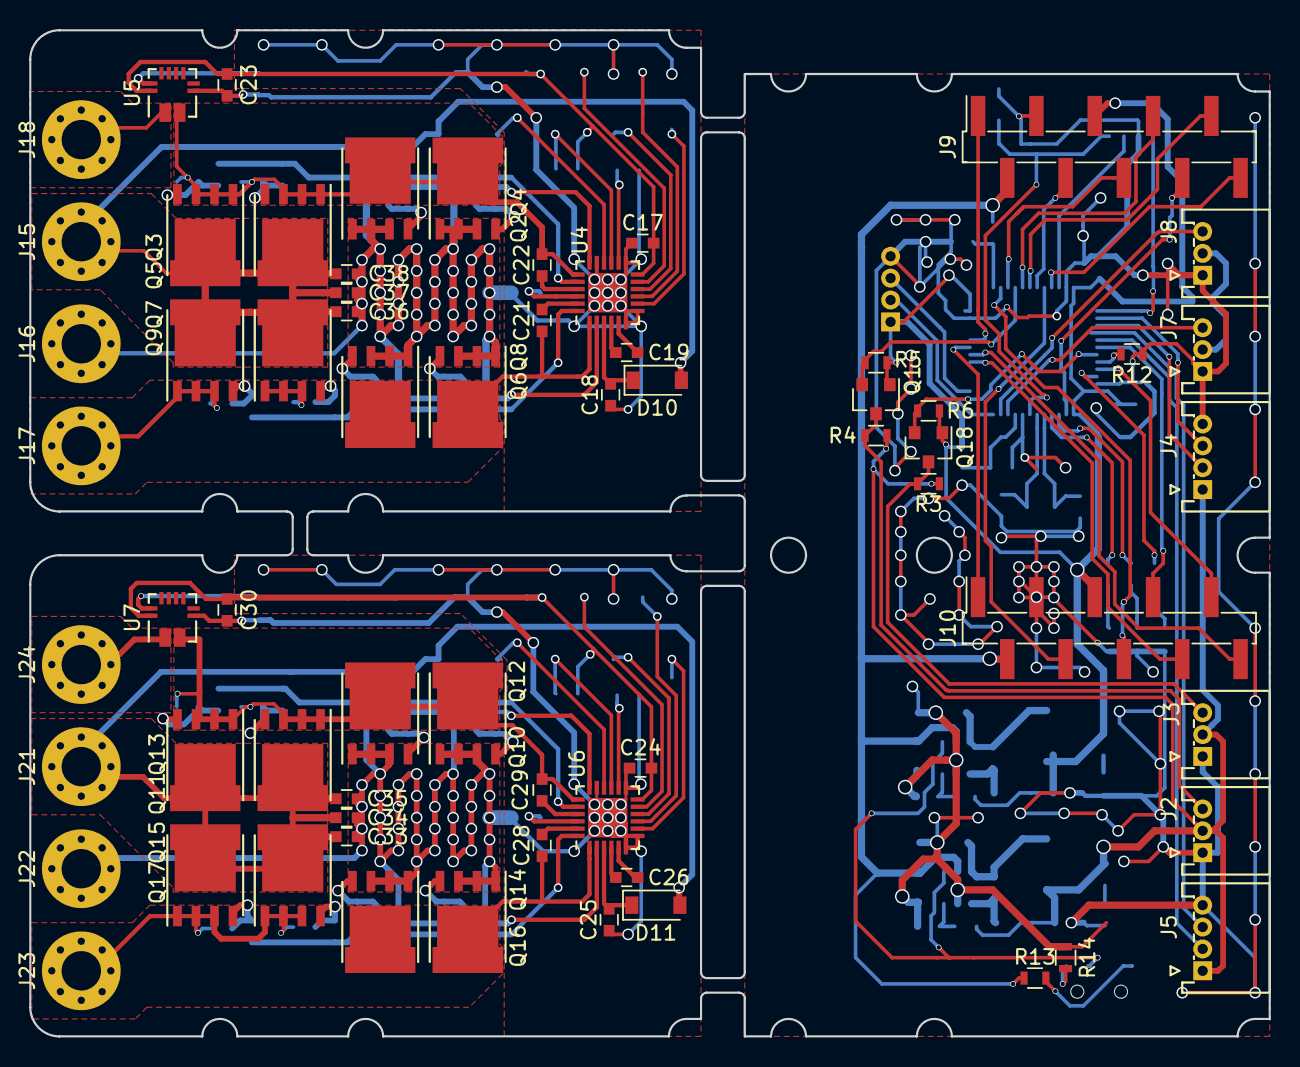
[picture p5: board nmkgmmd_v10_brd.kicad_pcb from above]

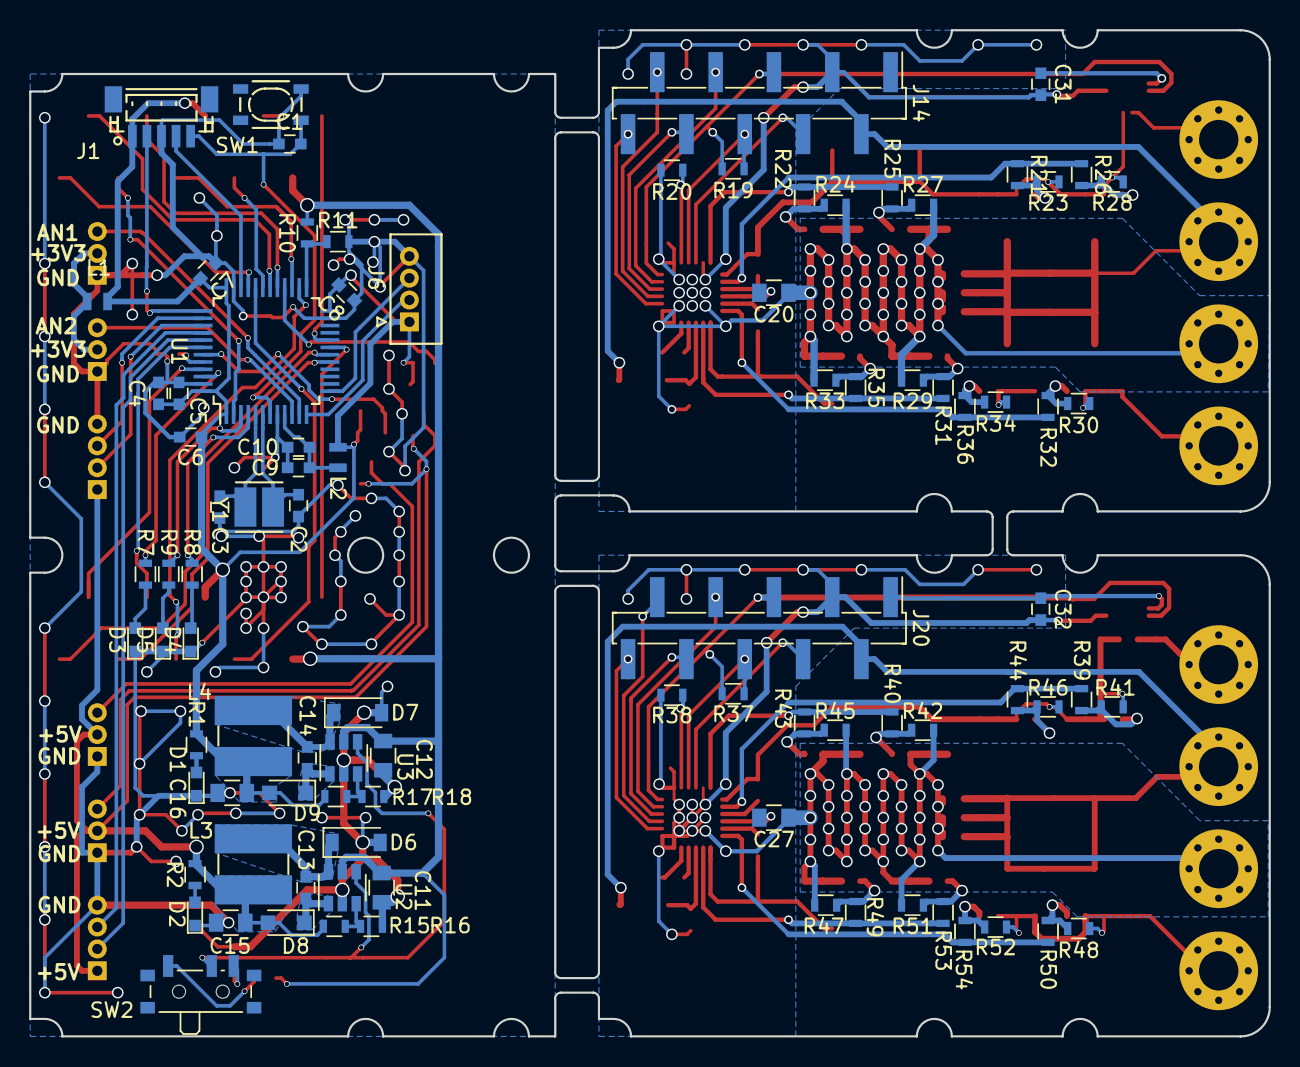
[picture p6: board nmkgmmd_v10_brd.kicad_pcb from below]

Board: 2 copper layers, 85.0 x 69.0 mm, 155 parts (90 on the bottom side), 114 nets.

Other parts of the board:
C26: 470u; C_0603

Their connections:
unnamed 47: C26.1; also elsewhere on the board
unnamed 48: C26.2; also elsewhere on the board
