Yuqlid/nmkgmmd_v10_brd/(commit log)

2017-02-22 石を303CC(48pin)に変更，少しだけピンを引き出した
    [nmkgmmd_v10_brd.sch]
2017-02-23 制御回路完成，アノテーション
    [Logic_Power.sch, Logic_Supply.sch, MCU.sch, nmkgmmd_v10_brd.kicad_pcb, nmkgmmd_v10_brd.sch]
2017-02-23 回路図作ってみた
    [Driver.sch, Logic_Power.sch, MCU.sch, nmkgmmd_v10_brd.kicad_pcb, nmkgmmd_v10_brd.sch]
2017-02-23 FETがパラになったｗｗｗ
    [Driver.sch]
2017-02-23 しんちょく
    [Driver.sch, nmkgmmd_v10_brd.kicad_pcb]
2017-02-25 進捗セーブ
    [Driver.sch, nmkgmmd_v10_brd.kicad_pcb]
2017-02-25 一度全部配線はできた，きれいにする必要あり
    [Driver.sch, nmkgmmd_v10_brd.kicad_pcb]
2017-02-26 しんちょくセーブ
    [_saved_Driver.sch, _saved_MCU.sch, nmkgmmd_v10_brd.kicad_pcb]
2017-02-26 アノテーション前のセーブ
    [Driver.sch, _saved_Driver.sch, _saved_MCU.sch, nmkgmmd_v10_brd.sch]
2017-02-27 進捗，セーブ
    [Driver.sch, nmkgmmd_v10_brd.kicad_pcb, nmkgmmd_v10_brd.sch]
2017-03-08 ネットリスト更新，進捗
    [nmkgmmd_v10_brd.kicad_pcb, nmkgmmd_v10_brd.sch]
2017-03-16 ネットリスト更新 配線編集
    [nmkgmmd_v10_brd.kicad_pcb, nmkgmmd_v10_brd.sch]
2017-03-24 塗り忘れのviaがあったから塗った
    [nmkgmmd_v10_brd.kicad_pcb]
2017-03-27 via修正
    [nmkgmmd_v10_brd.kicad_pcb]
2017-03-28 外形修正
    [nmkgmmd_v10_brd.kicad_pcb]
2017-03-30 ライブラリの関係修正
    [nmkgmmd_v10_brd.kicad_pcb]
2017-04-03 MCP16301のアップデート
    [Driver.sch, Logic_Power.sch, MCU.sch, nmkgmmd_v10_brd.sch]
2017-04-06 これで発注します
    [nmkgmmd_v10_brd-B.Cu.gbr, nmkgmmd_v10_brd-B.SilkS.gbr, nmkgmmd_v10_brd-Edge.Cuts.gbr, nmkgmmd_v10_brd-F.Cu.gbr, nmkgmmd_v10_brd-F.SilkS.gbr, nmkgmmd_v10_brd.drl]
2017-04-06 ドリルデータをミスってた＆マスク出し忘れてたのでこっちで発注
    [nmkgmmd_v10_brd-B.Cu.gbr, nmkgmmd_v10_brd-B.Mask.gbr, nmkgmmd_v10_brd-B.SilkS.gbr, nmkgmmd_v10_brd-Edge.Cuts.gbr, nmkgmmd_v10_brd-F.Cu.gbr, nmkgmmd_v10_brd-F.Mask.gbr, nmkgmmd_v10_brd-F.SilkS.gbr, nmkgmmd_v10_brd-NPTH.drl]
2017-04-07 値を割り当ててない部品があったので幾つ値を追加した
    [nmkgmmd_v10_brd.csv]
2017-04-25 配線忘れがあってElecrowから連絡が来たのでつなげてデータを送った
    [nmkgmmd_v10_brd.kicad_pcb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]
2017-05-01 BOM作った
    [nmkgmmd_v10_brd.csv, nmkgmmd_v10_brd.xlsx]
2017-05-09 470uだったのところを470nに修正 ネットリスト変更して再アノテーションした ピンソケットとピンヘッダ以外のBOMだしおわり
    [Driver.sch, nmkgmmd_v10_brd.csv, nmkgmmd_v10_brd.kicad_pcb, nmkgmmd_v10_brd.xlsx]
2017-05-09 Digikeyのかごに追加した
    [nmkgmmd_v10_brd.xlsx]
2017-05-09 コンデンサのサイズを0805から1206に大きくした
    [Logic_Power.sch]
2017-05-09 ブートストラップコンデンサの値を決めた
    [Driver.sch]
2017-05-09 LEDの抵抗を決めた
    [nmkgmmd_v10_brd.sch]
2017-05-09 変更を適用してネットリスト出力
2017-05-09 部品の値を修正
    [nmkgmmd_v10_brd.xlsx]
